aymanreda56/Hyper_Bot/README.md

# Hyper_Bot
line follower and maze solving robot, cufe computer department embedded systems course project
