aymanreda56/Hyper_Bot/Proteus Simulation/Capture.PNG

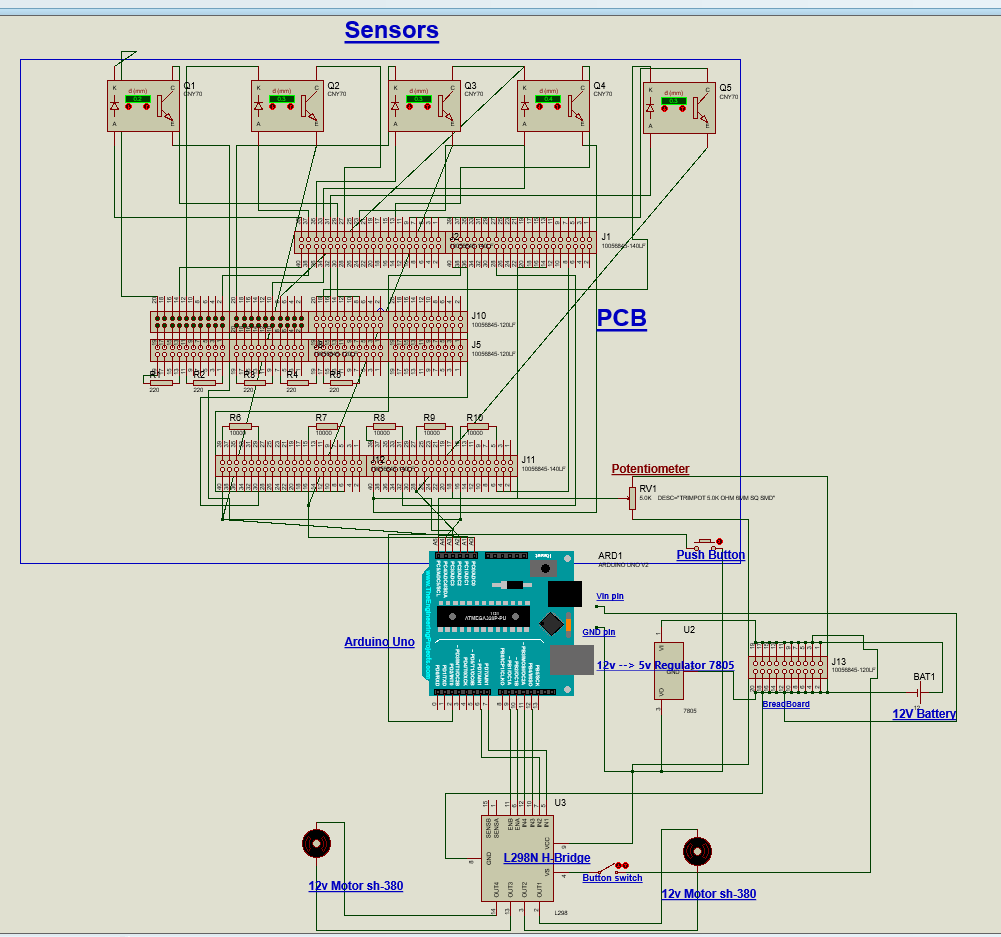
Proteus Simulation/Capture.PNG
