aymanreda56/Hyper_Bot/Schematic.jpg

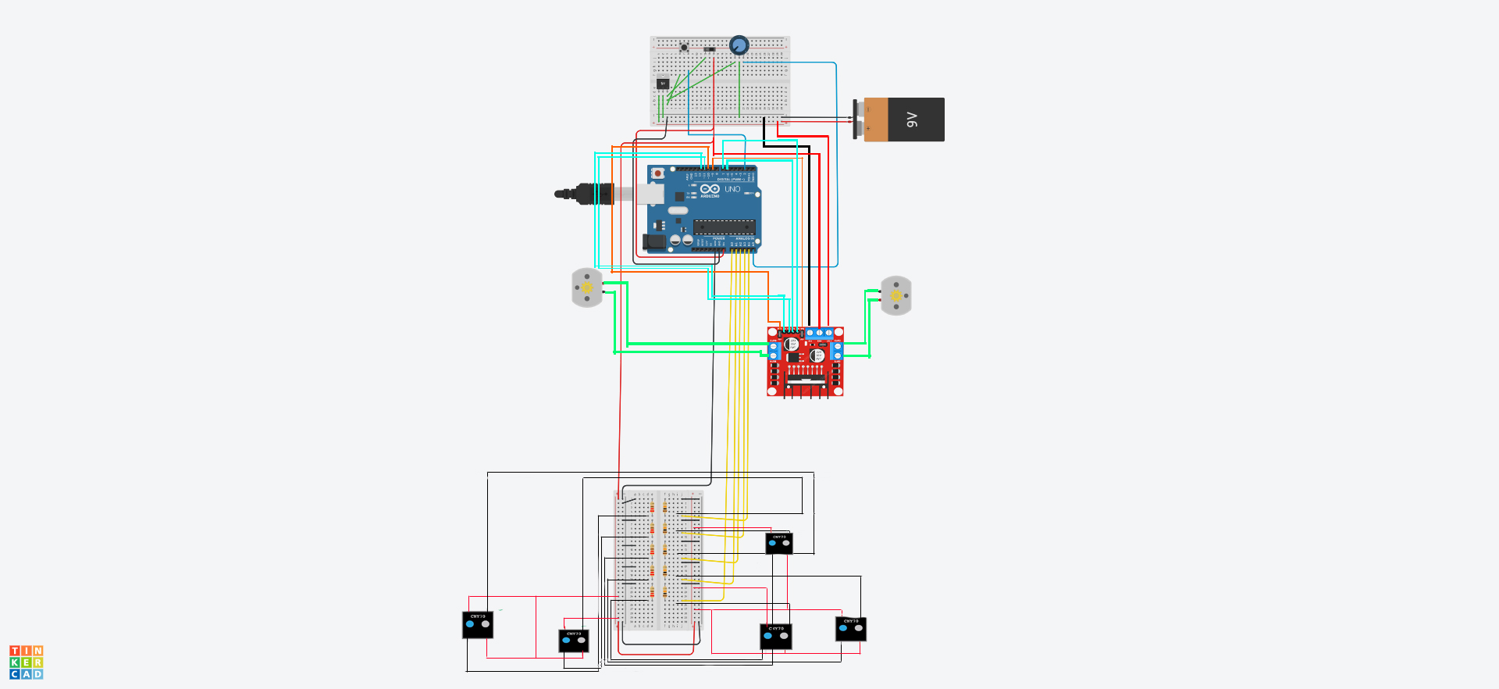
Schematic.jpg
