aymanreda56/Hyper_Bot/Proteus Simulation/Schematic PDF.PDF

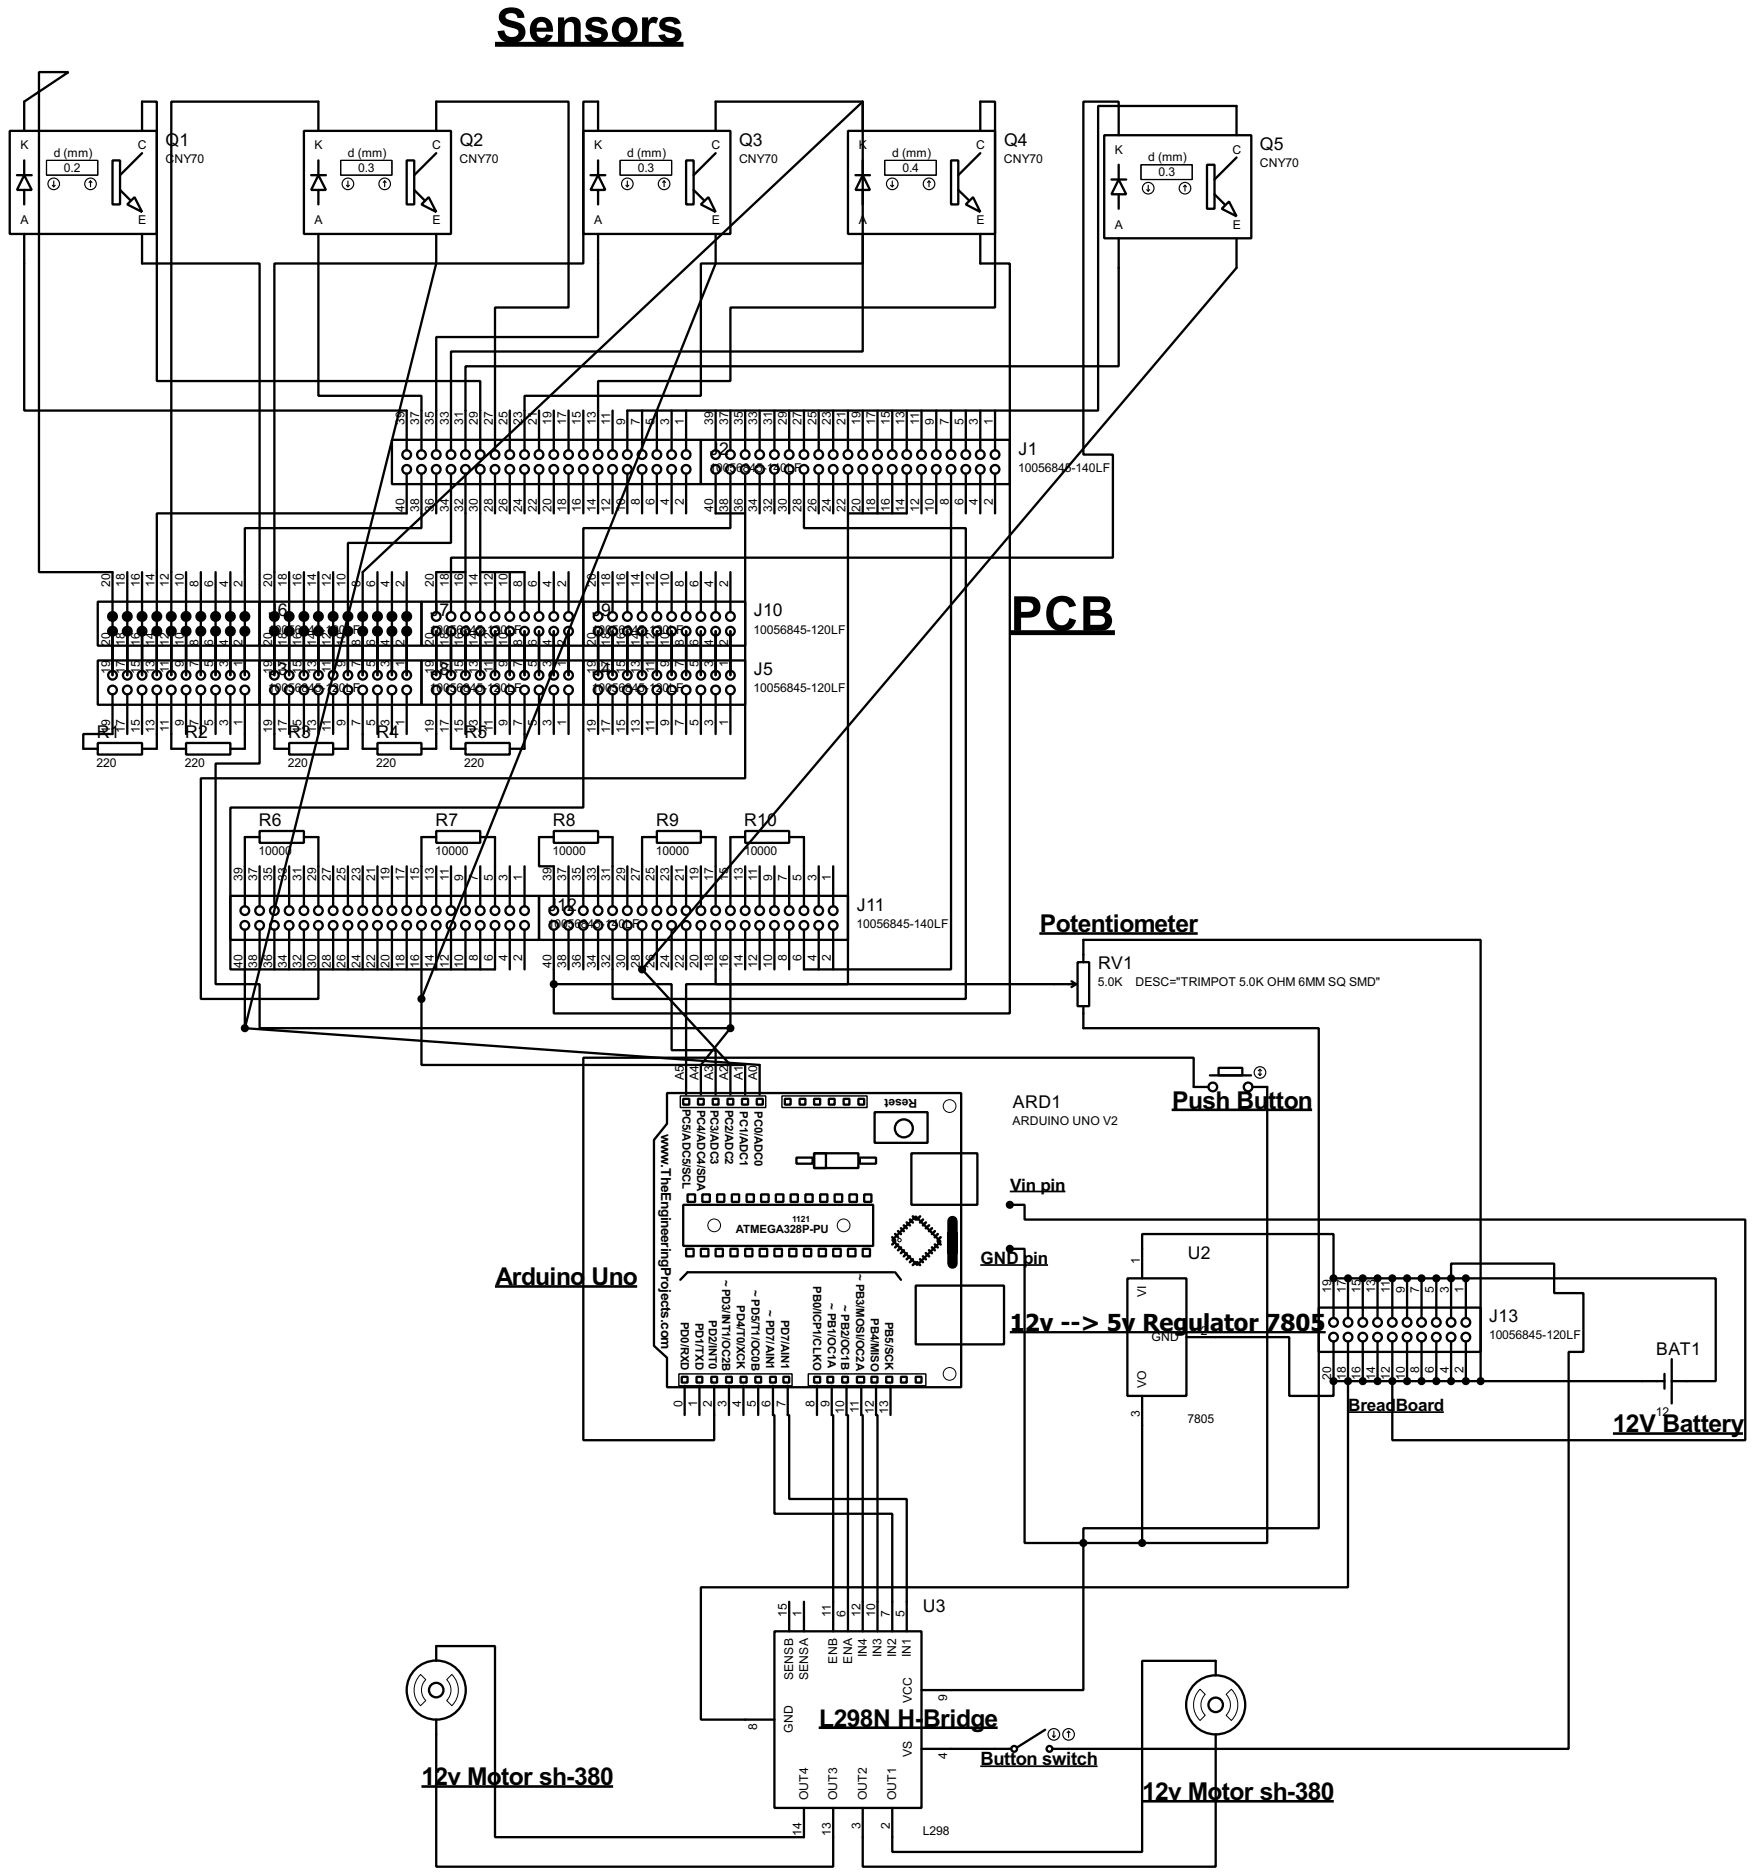
[picture p9: page 1]

5.0K DESC="TRIMPOT 5.0K OHM 6MM SQ SMD"
