aymanreda56/Hyper_Bot/(list of files, drawings)

Other design files:
Proteus Simulation/ES_TEAM8.pdsprj
