aymanreda56/Hyper_Bot/sensor_code/sensor_code.ino

#include<string.h>

int reading1;
int reading2; 
int reading3;
int reading4;
int reading5;
void setup(){
  Serial.begin(9600);
  delay(50);
  //DDRC = 0b00000000;
  pinMode(A2, INPUT);
  pinMode(A1, INPUT);
  pinMode(A0, INPUT);
  pinMode(A3, INPUT);
  pinMode(A4, INPUT);
  pinMode(A5, INPUT);


   pinMode(2, INPUT);
  
}
unsigned long t0 = 0;
unsigned long t1 = 0;
bool flag = false;
int button = 0;

void loop(){

  //button = digitalRead(2);
   /*digitalWrite(4, HIGH);
  digitalWrite(5, LOW);*/

  delay (5);
 reading1 = analogRead(A0);
  delay (5);
reading2 = analogRead(A1);
  delay (5);
reading3 = analogRead(A2);
  delay (5);
 reading4 = analogRead(A3);
  delay (5);
  reading5 = analogRead(A4);
  delay (5);
 // delay (20);
  Serial.println(" ");
  Serial.print(reading1);
  Serial.print("            ");
  Serial.print(reading2);
    Serial.print("            ");

  Serial.print(reading3);
    Serial.print("            ");

  Serial.print(reading4);
    Serial.print("            ");

  Serial.print(reading5);
    Serial.print("            ");


   //Serial.print(button);


      
      
    
}
